fiuba-labo-de-micro-miercoles/2019-2c-trabajo-practico-labo_micros/README.md

# Proyecto: _Láser_ autonivelante

6609/8607 Laboratorio de Microcontroladores

## Integrantes

- Gonzalo L. Petraglia - 97811
- Patricio Iribarne Catella - 96619

## Descripción

La característica principal de este proyecto es el poder construir un dispositivo electrónico capaz de generar un haz de luz láser, el cual muestre el nivel proyectado en una superficie (ej: una pared).

Para que el usuario no necesite calibrar ni ajustar el nivel de forma manual, el dispositivo lo hará automáticamente. Una vez encendido, éste tomará la información sobre las características del suelo (mediante un giróscopo/acelerómetro), y rotará el láser para que el nivel proyectado sea el correcto.

Para mayor facilidad en su uso, de ser necesario, se podrá acoplar el dispositivo a un trípode, el cual se adaptará a las irregularidades del terreno.
