fiuba-labo-de-micro-miercoles/2019-2c-trabajo-practico-labo_micros/(threads)

Thread 3 (2019-10-25):

Comunicación serial

gonzalpetraglia, 2019-10-25:
Subimos, a metodo de prueba de la comunicación serial, para luego poder leer los valores devueltos por los sensores desde la PC, un programa chiquito que permite enviar desde el micro a la PC infinitamente el caracter 'a'. Queriamos confirmar que estaba bien, aunque ya vimos que funciona

rarias, 2019-10-26:
ok, es la mejor prueba de que el código está bien.
Una sola cosa respecto al código, agreguen siempre como comentario al inicio, qué micro usan y a qué frecuencia.
Slds

Closed 2019-10-26.

Thread 5 (2019-10-29):

Girósocopo/Acelerómetro

PatricioIribarneCatella, 2019-10-29:
#4 ¿Este giróscopo/acelerómetro es el correcto?

rarias, 2019-10-30:
Sí, este va bien.
Mañana.les paso el ABC para comunicar el micro con este sensor.
Slds

El mar., 29 oct. 2019 19:54, Patricio Iribarne Catella <
notifications@github.com> escribió:

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

Closed 2019-10-30.

Thread 6 (2019-11-07):

No funciona correctamente I2C

PatricioIribarneCatella, 2019-11-07:
- Se establece la comununicación.
- Puede leer varios bytes.
- Los bytes recibidos, parecen ser todos cero.

PatricioIribarneCatella, 2019-11-07:
Se utiliza el _Arduino MEGA-2560_ de 16Mhz

rarias, 2019-11-07:
Es prácticamente imposible de seguir su código, abusan del "CALL".   Les pasé un código "plano" probado, pueden hacer una prueba sencilla y ver si logran hacerlo andar?

PatricioIribarneCatella, 2019-11-08:
Si esa prueba la hicimos y anda, con lo cual se puede descartar un problema en el circuito. Dentro del archivo **i2c.S** se encuentra definida la función `i2c_init` que realiza lo mismo que el código que nos pasaste (y esa parte funciona también). Solamente está dividida en distitntas funciones para poder utilizarlas luego en la lectura de cada uno de los bytes para obtener la acelaración y la inclinación. Lo que no nos anda es realizar la lectura de esos sucesivos bytes.

PatricioIribarneCatella, 2019-11-09:
Acabo de encontrar el problema! Por _default_ el **sensor viene apagado**. Hay un registro en particular, el `0x6B` que tiene un bit que es de _sleep-mode_ y viene en 1, indicando que arranca en ese modo. Hay que escribirlo con un 0 para que se prenda el sensor. Subí en la carpeta de _hojas de datos_ el _register-map_ donde aclara todo esto.

Por eso podía leer bien el valor de `WHO_AM_I` pero leía todos ceros (valor por defalut de todos los registros) en los demás bytes.

Luego, vamos a estar agregando ese código para realizar la escritura correspondiente en ese registro, en la función de inicialización.

Closed 2019-11-13.

Thread 8 (2019-11-11):

Motor stepper y driver

PatricioIribarneCatella, 2019-11-11:
En la _pull-request_ #7 se agregaron los _data-sheets_ de el motor y el driver. Por lo que entendimos  tiene una reducción de 1:64 con lo cual utilizando _half-steps_ se podría llegar a 512 pasos, lo que daría un ángulo de 0.70. También, parece que habría que utilizar una fuente externa de 5v para no dañar el _arduino_. Queríamos saber si eso es correcto.

rarias, 2019-11-13:
Si la corriente que mueve al motor es muy baja, digamos 100 a 250mA se podría usar la misma fuente.

Closed 2019-11-14.

Thread 11 (2019-12-07):

Correcciones pedidas realizadas

gonzalpetraglia, 2019-12-07:
Nos gustaria que revisen lo que hicimos:
- Agregamos las interrupciones del timer para reemplazar el delay
- Completamos la documentación
- Corregimos el reporte reemplazando las menciones de Arduino cambiandolo a la mención del microcontrolador AVR donde correspondia
- Removimos codigo inutilizado

Closed 2019-12-18.
