fiuba-labo-de-micro-miercoles/2019-2c-trabajo-practico-labo_micros/esquematico/laser-nivel.pdf

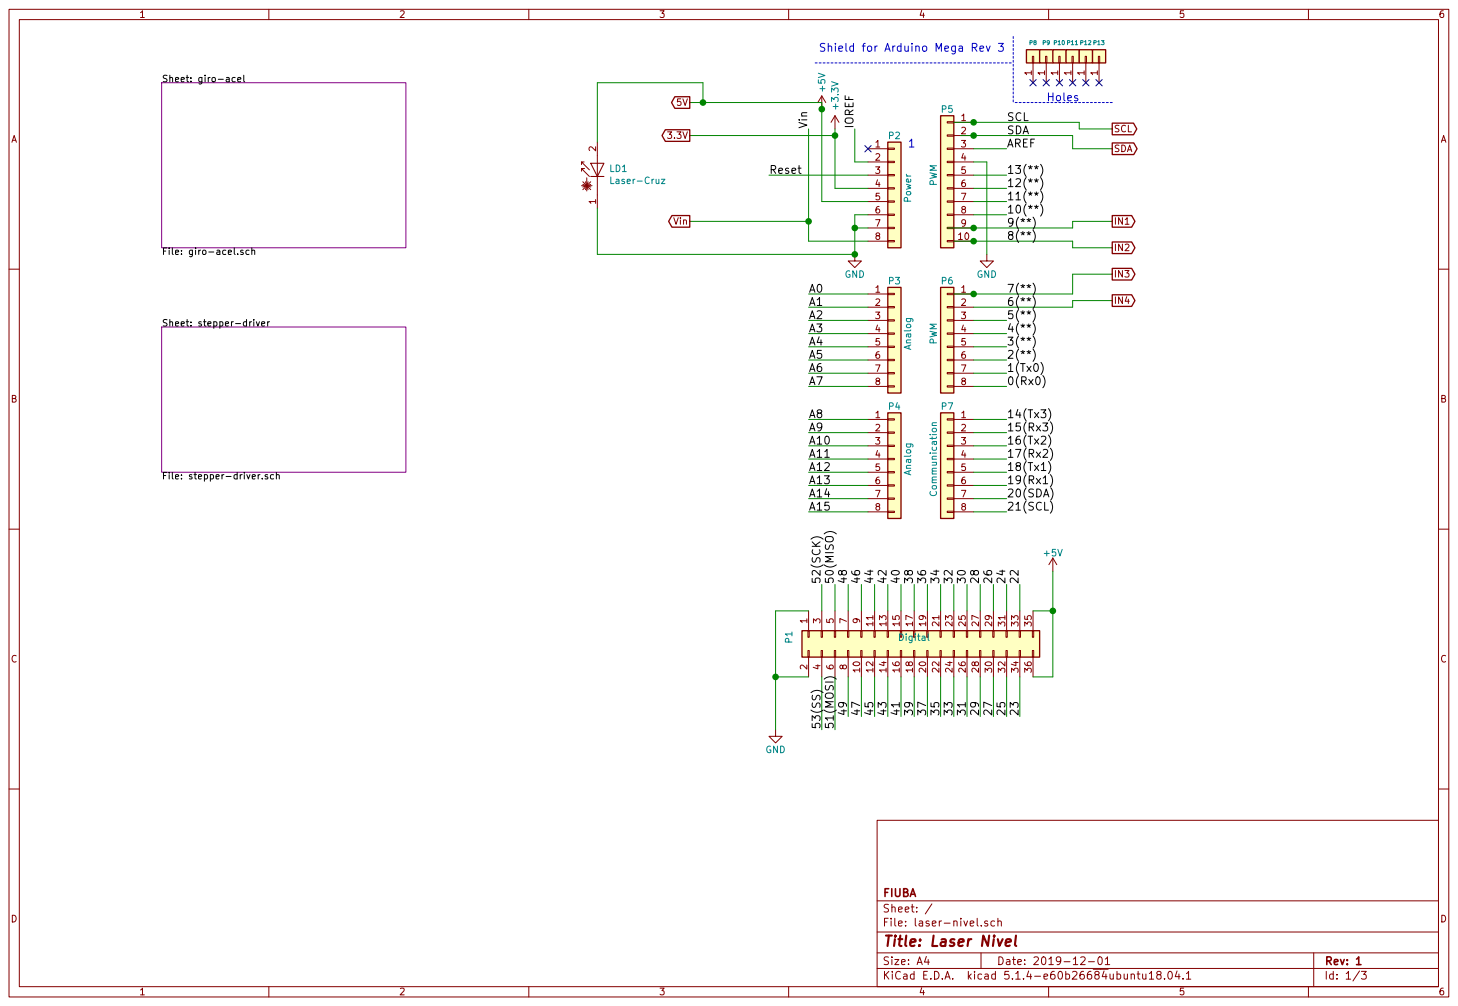
[picture p8: page 1]

File: stepper-driver.sch

Id: 1/3 Title: Laser Nivel File: laser-nivel.sch Sheet: / FIUBA

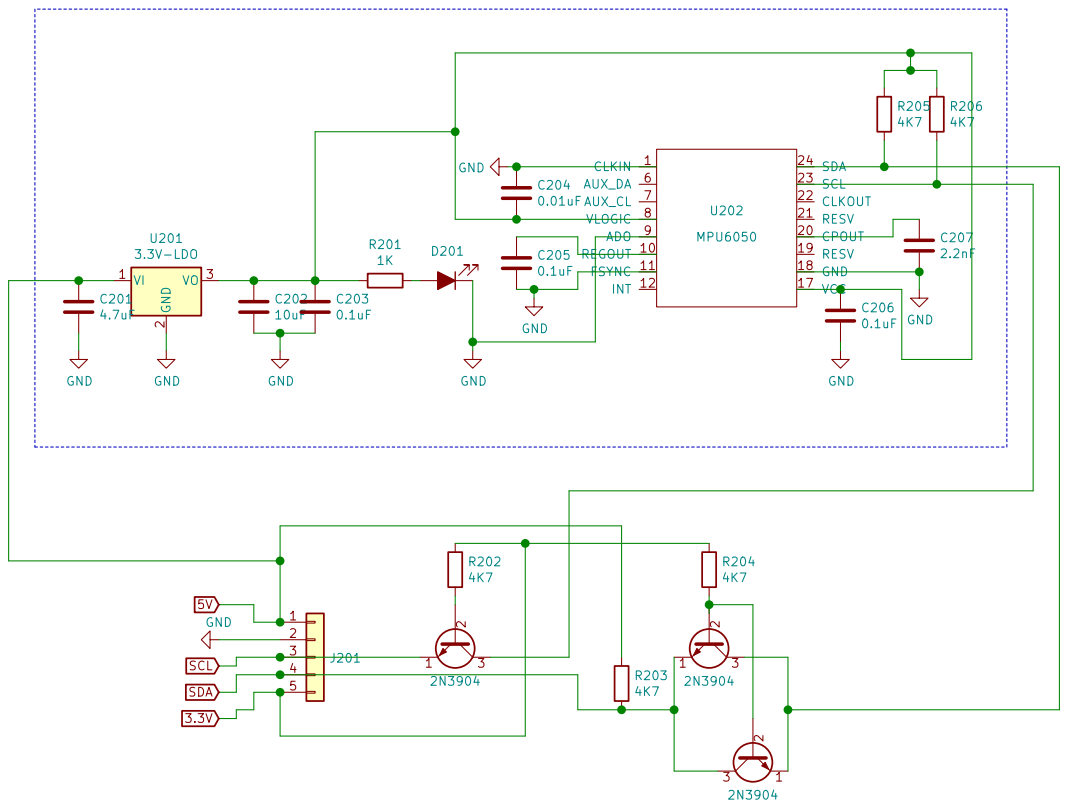
[picture p9: page 2]

Sheet: /giro-acel/
File: giro-acel.sch
Id: 2/3 Title: Laser Nivel

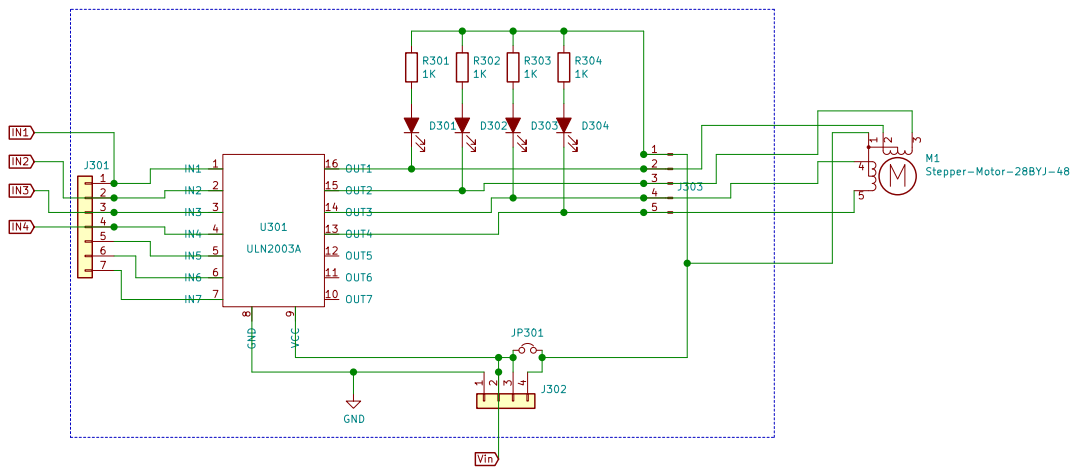
[picture p10: page 3]

Sheet: /stepper-driver/
File: stepper-driver.sch
Id: 3/3 Title: Laser Nivel
