fiuba-labo-de-micro-miercoles/2019-2c-trabajo-practico-labo_micros/esquematico/MPU6050/MPU6050.kicad_pcb

## KiCad design mixer.sch

Schematic: mixer.sch

Parts:
J1: AudioJack3_Ground
RV1: 47k

Notes on the sheet:
NJM2505A
