fiuba-labo-de-micro-miercoles/2019-2c-trabajo-practico-labo_micros/(commit log)

2019-10-02 Se agrega descripción en el README
2019-10-30 Add .gitignore and skell files for serial and i2c interface
2019-10-30 Add start function for I2C
2019-10-30 Some fixes and receive function for I2C protocol
    [i2c.h]
2019-10-30 conexión micro con sensor
2019-10-30 i2c básico para manejar el sensor
2019-10-31 Add I2C protocol: divided into different functions to START, CONNECT, READ and END the connection
2019-11-10 FIX: missing sensors enable for MPU to work correctly
    [i2c.h]
2019-11-11 Add stepper and driver data sheets
2019-11-12 Add laser data-sheet
2019-11-13 WIP: stepper motoro code
2019-11-14 Some fixes in stepper
2019-11-16 Working with assembly
2019-11-16 Done with Stepper motor code. Reorder tests in folder
2019-11-16 Add useful information about stepper motors
2019-11-17 Add first try of KiCAD
    [laser-nivel.kicad_pcb, laser-nivel.sch]
2019-11-18 Add schematics: Arduino, MPU6050 and ULN2003A. They are not connected yet
    [MPU6050.kicad_pcb, MPU6050.sch, ULN2003A.kicad_pcb, ULN2003A.sch, laser-nivel.sch]
2019-11-26 Arduino ds
2019-11-26 First integration with stepper and gyroscope
2019-11-28 Add the last details to make the motor turn in correspondence with the yroscope
2019-12-02 Done with schematic
    [giro-acel.sch, laser-nivel.sch, stepper-driver.sch]
2019-12-03 Update schematic
    [stepper-driver.sch]
2019-12-03 More updates to schematic
    [giro-acel.sch, laser-nivel.sch]
2019-12-06 Add interruptions
2019-12-08 Add new flowchar to report
